ColumbiaGadgetWorks/scorbot/hardware/drv8874-carrier/fab/b/rfq/RFQ_NOTES.txt

DRV8874 carrier, version B - RFQ
=================================

Bare board
  Layers           2, FR-4, 1.6 mm, 1 oz copper both sides
  Finish           HASL (lead-free OK) or ENIG
  Mask / silk      any colour mask, white silk, both sides
  Min track/space  0.15 mm / 0.15 mm
  Min drill        0.3 mm vias (tented), 1.02 mm header holes, 1.152 mm NPTH tooling holes
  Board            15.24 x 17.78 mm (0.6 x 0.7 in)
  Panel            3 x 2 boards, 45.72 x 45.56 mm, V-cut
                   between boards and along both rails (all straight internal lines on the
                   outline layer are V-cuts). 5 mm rails top and bottom with 3 fiducials
                   and 4 tooling holes.

Assembly
  SMT, top side only, 10 placements per board (60 per panel).
  Bottom side has no parts. The 1x7 headers (J1, J2) are not fitted.
  U1 (DRV8874PWPR) has a thermal pad; solder it fully to the pad
  (solder-mask-defined opening, 2 paste windows, vias under the pad).
  Pin 1 of U1 is at the lower-left, next to the silkscreen triangle.

Placement files
  CPL_panel.csv / CPL_single.csv: centre of each part in mm from the lower-left
  corner of the panel (or board), Y up, rotation counter-clockwise in KiCad /
  IPC-7351 zero orientation. (For JLCPCB use fab/b/panel/jlc_cpl.csv, which
  has JLC's rotation correction for U1.)

Quantity
  e.g. 2 panels = 12 boards (bare boards: 5 panels minimum at most fabs)
