ColumbiaGadgetWorks/scorbot/hardware/drv8874-carrier/docs/panel_b.png

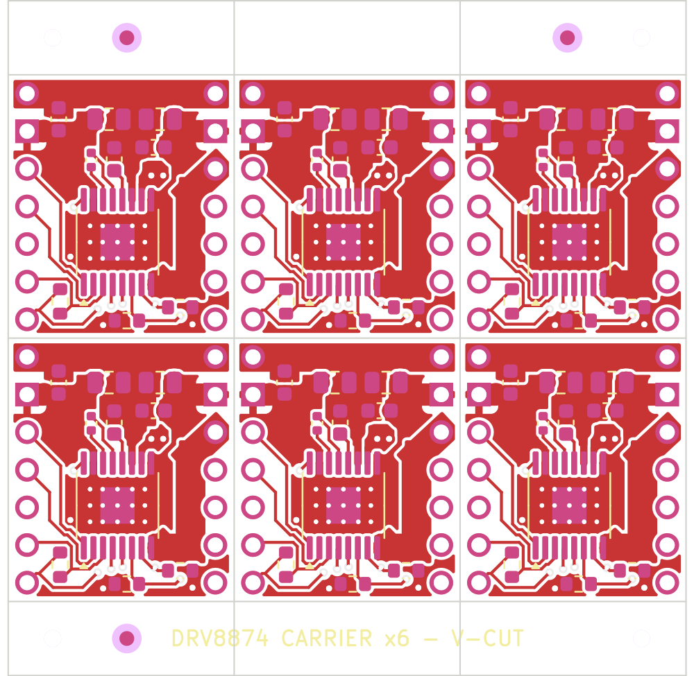
hardware/drv8874-carrier/docs/panel_b.png
