ColumbiaGadgetWorks/scorbot/hardware/drv8874-carrier/docs/version_a.png

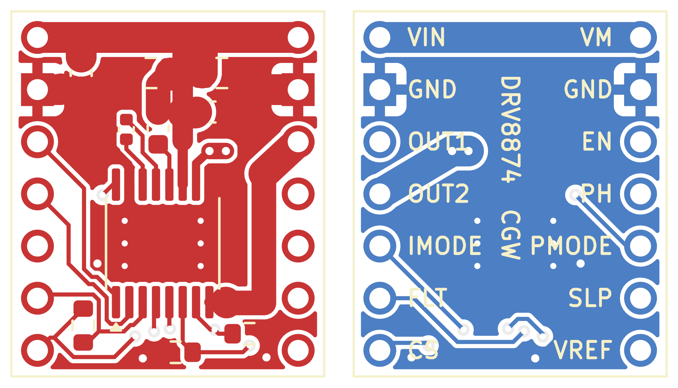
hardware/drv8874-carrier/docs/version_a.png
