ColumbiaGadgetWorks/scorbot/hardware/scorbot-controller/art/stealie.png

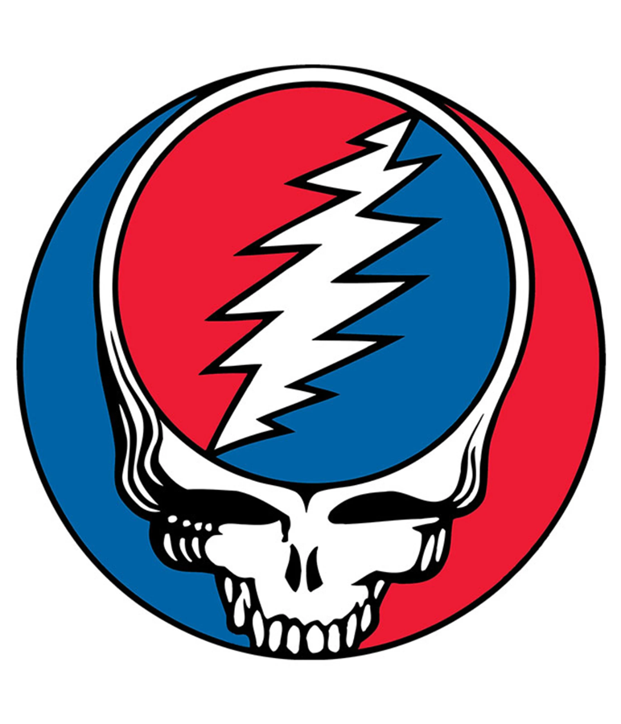
hardware/scorbot-controller/art/stealie.png
