ColumbiaGadgetWorks/scorbot/hardware/scorbot-controller/docs/pcb_placement.png

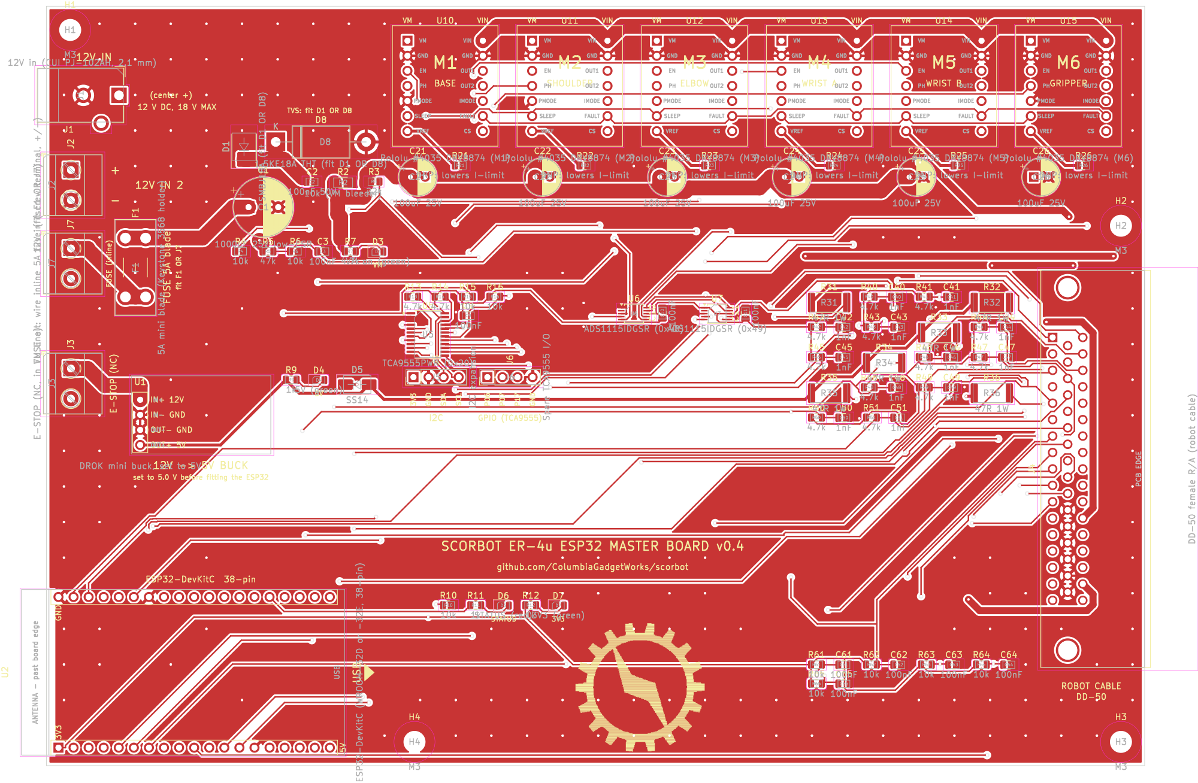
hardware/scorbot-controller/docs/pcb_placement.png
