ColumbiaGadgetWorks/scorbot/hardware/scorbot-controller/docs/pcb_routed_B.png

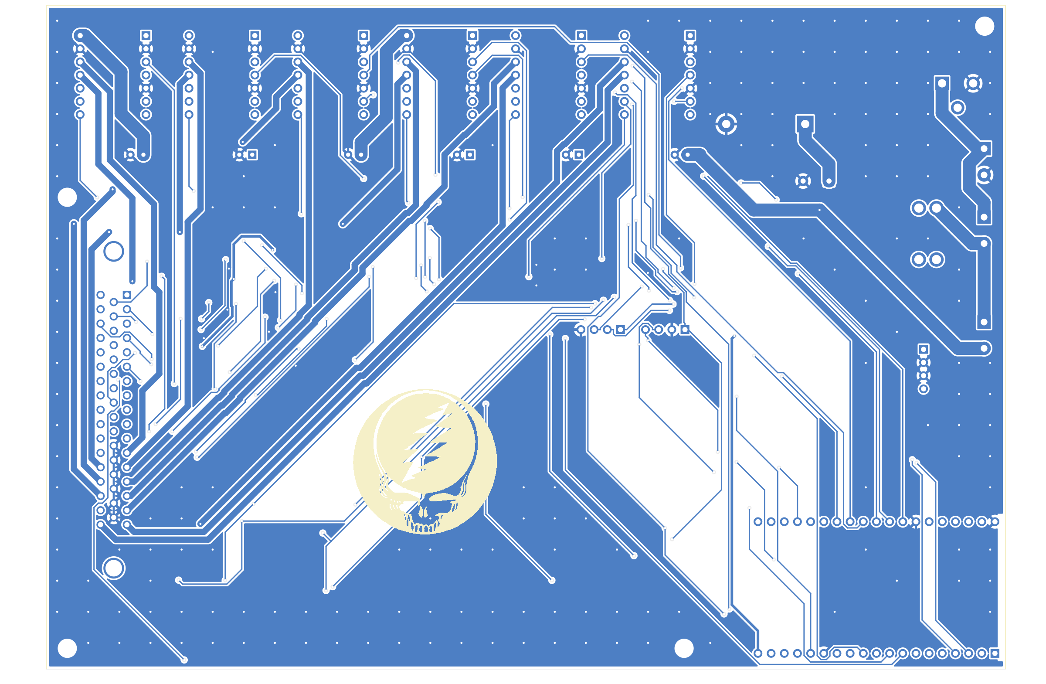
hardware/scorbot-controller/docs/pcb_routed_B.png
