ColumbiaGadgetWorks/scorbot/hardware/drv8874-carrier/fab/JLC_upload_6up_version_b/2_BOM_drv8874_6up.csv

Comment | Designator | Footprint | LCSC Part #
100nF 50V | C3_1,C3_2,C3_3,C3_4,C3_5,C3_6,C4_1,C4_2,C4_3,C4_4,C4_5,C4_6,C6_1,C6_2,C6_3,C6_4,C6_5,C6_6 | C_0603_1608Metric | C14663
DRV8874PWPR | U1_1,U1_2,U1_3,U1_4,U1_5,U1_6 | HTSSOP-16-1EP_4.4x5mm_P0.65mm_EP3.4x5mm_Mask2.46x2.31mm | C1855818
10uF 25V | C1_1,C1_2,C1_3,C1_4,C1_5,C1_6,C2_1,C2_2,C2_3,C2_4,C2_5,C2_6 | C_0805_2012Metric | C15850
10k | R2_1,R2_2,R2_3,R2_4,R2_5,R2_6 | R_0603_1608Metric | C25804
20k | R4_1,R4_2,R4_3,R4_4,R4_5,R4_6 | R_0603_1608Metric | C4184
2.4k 1% | R3_1,R3_2,R3_3,R3_4,R3_5,R3_6 | R_0603_1608Metric | C22940
22nF 50V | C5_1,C5_2,C5_3,C5_4,C5_5,C5_6 | C_0402_1005Metric | C1532
