ColumbiaGadgetWorks/scorbot/hardware/scorbot-controller/docs/schematic.pdf

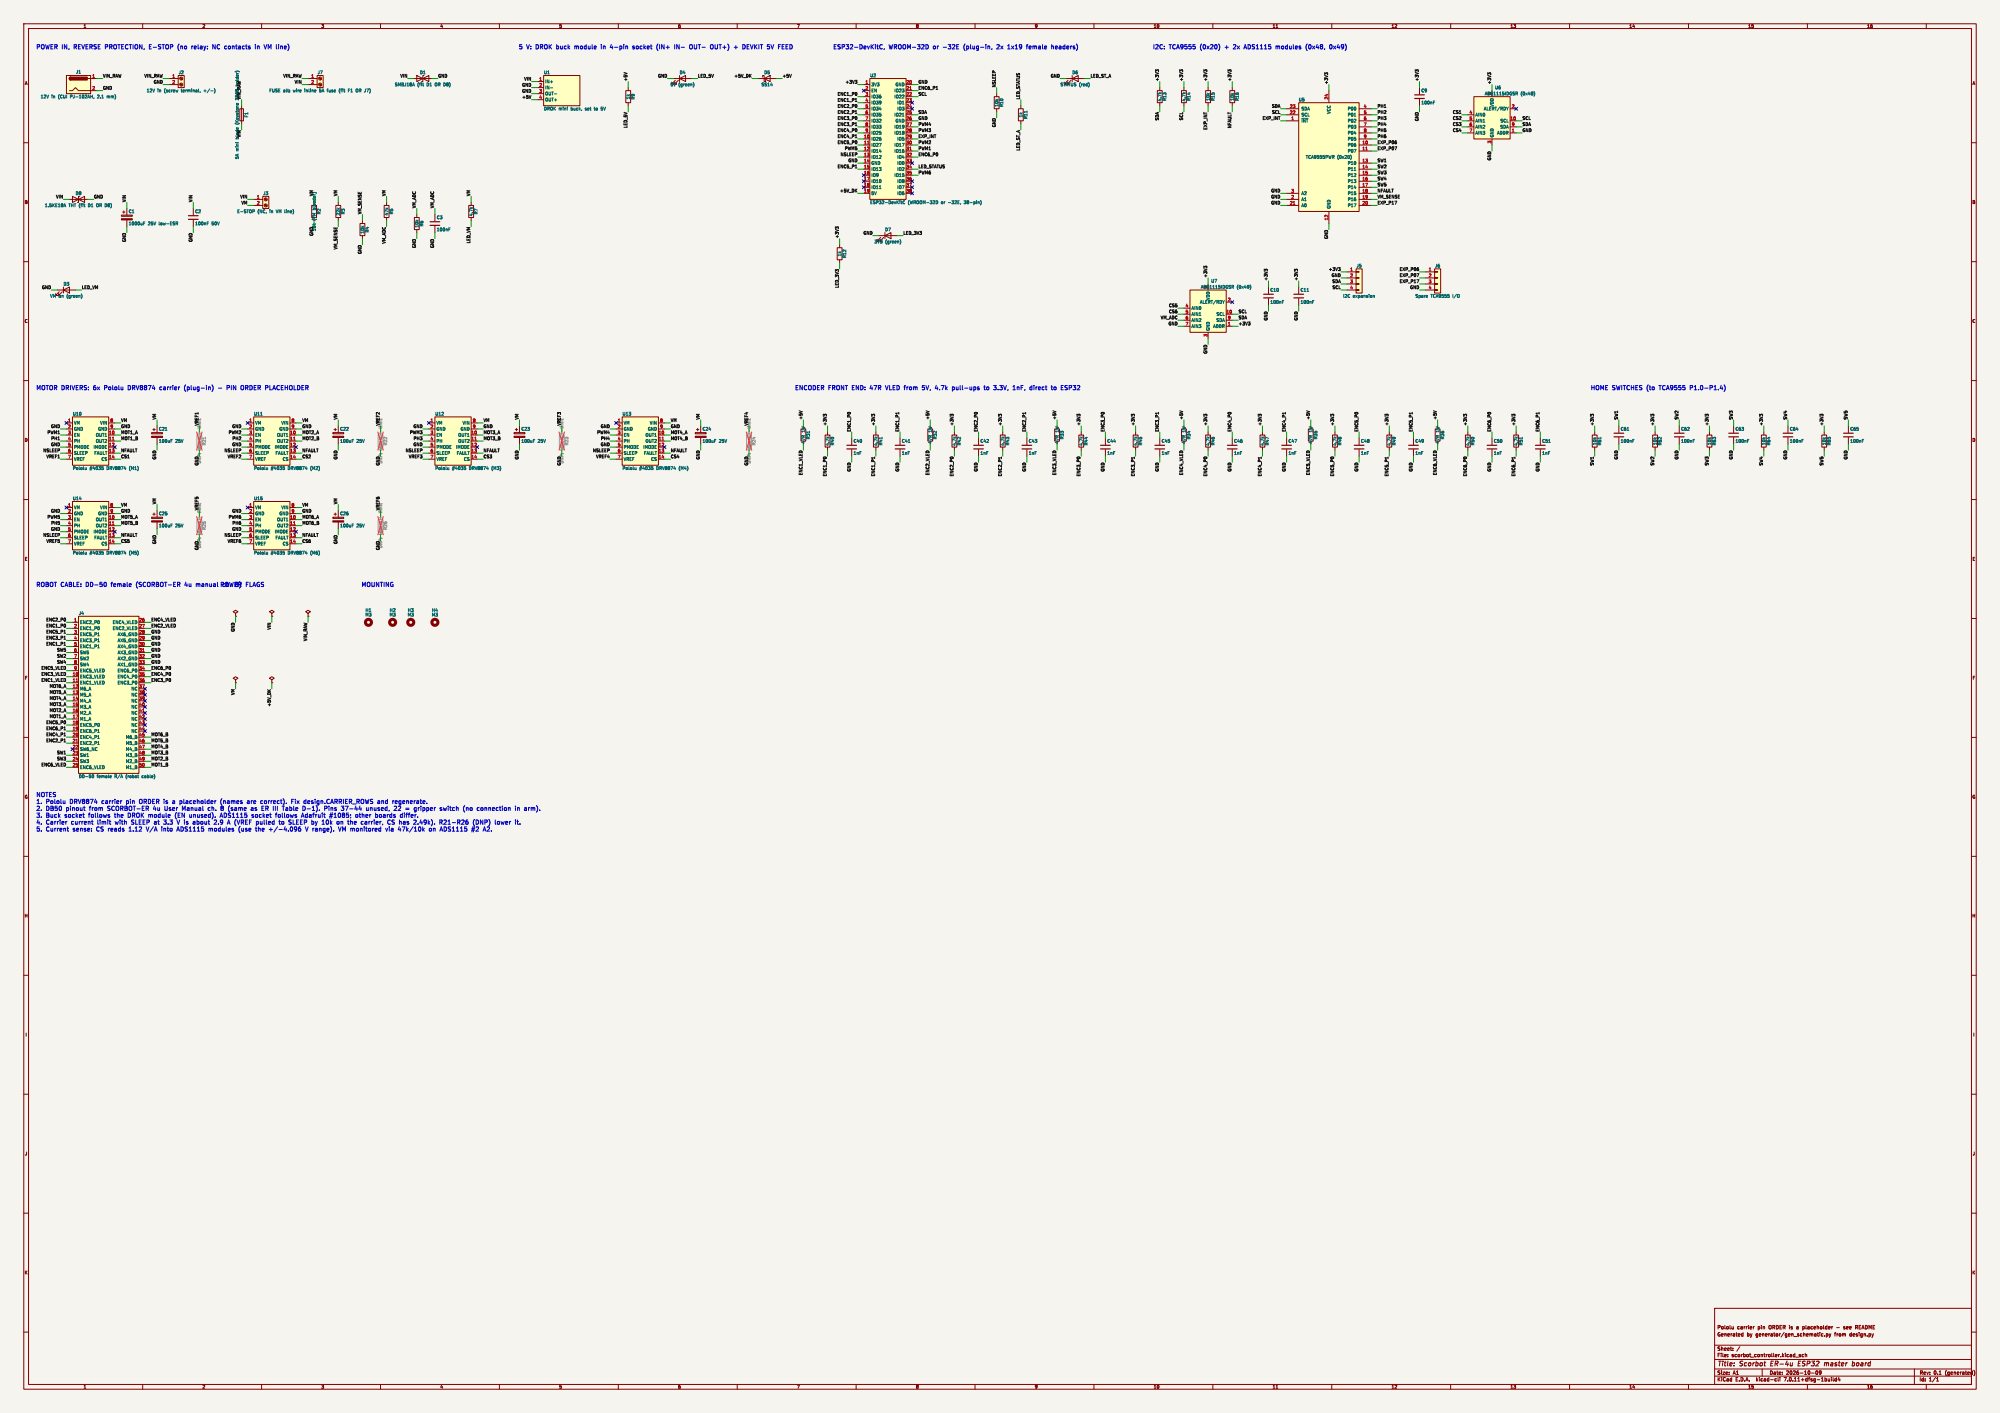
[picture p6: page 1]

J7 FUSE alt: wire inline 5A fuse (fit F1 OR J7) 1

SCL SDA GND GND
