ColumbiaGadgetWorks/scorbot/hardware/drv8874-carrier/drv8874_carrier_panel.kicad_pcb

## KiCad design hardware/drv8874-carrier/drv8874_carrier_panel.kicad_pcb (2026-10-27)

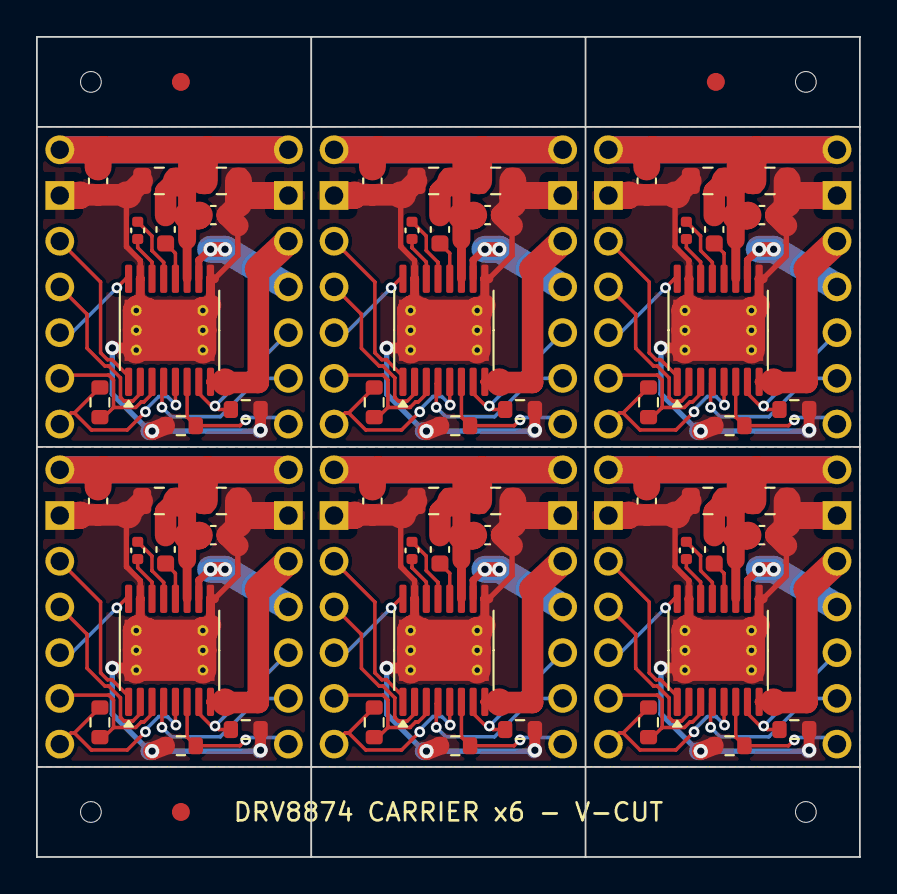
[picture p10: board drv8874_carrier_panel.kicad_pcb from above]

Board: 2 copper layers, 45.7 x 45.6 mm, 79 parts (0 on the bottom side), 15 nets.

Parts:
C1_1, C1_2, C1_3, C1_4, C1_5, C1_6, C2_1, C2_2, C2_3, C2_4, C2_5, C2_6: 10uF 25V; C_0805_2012Metric
C3_1, C3_2, C3_3, C3_4, C3_5, C3_6, C4_1, C4_2, C4_3, C4_4, C4_5, C4_6, C6_1, C6_2, C6_3, C6_4, C6_5, C6_6: 100nF 50V; C_0603_1608Metric
C5_1, C5_2, C5_3, C5_4, C5_5, C5_6: 22nF 50V; C_0402_1005Metric
FID1, FID2, FID3: Fiducial_1mm_Mask2mm
H1, H2, H3, H4: (no value)
J1_1, J1_2, J1_3, J1_4, J1_5, J1_6, J2_1, J2_2, J2_3, J2_4, J2_5, J2_6: 1x7 0.1in pins (hand-soldered); PinHeader_1x07_P2.54mm_Vertical
R2_1, R2_2, R2_3, R2_4, R2_5, R2_6: 10k; R_0603_1608Metric
R3_1, R3_2, R3_3, R3_4, R3_5, R3_6: 2.4k 1%; R_0603_1608Metric
R4_1, R4_2, R4_3, R4_4, R4_5, R4_6: 20k; R_0603_1608Metric
U1_1, U1_2, U1_3, U1_4, U1_5, U1_6: DRV8874PWPR; HTSSOP-16-1EP_4.4x5mm_P0.65mm_EP3.4x5mm_Mask2.46x2.31mm

Connections:
CPH: C5_1.2, C5_2.2, C5_3.2, C5_4.2, C5_5.2, C5_6.2, U1_1.13, U1_2.13, U1_3.13, U1_4.13, U1_5.13, U1_6.13
CPL: C5_1.1, C5_2.1, C5_3.1, C5_4.1, C5_5.1, C5_6.1, U1_1.14, U1_2.14, U1_3.14, U1_4.14, U1_5.14, U1_6.14
CS: J2_1.7, J2_2.7, J2_3.7, J2_4.7, J2_5.7, J2_6.7, R3_1.2, R3_2.2, R3_3.2, R3_4.2, R3_5.2, R3_6.2, U1_1.6, U1_2.6, U1_3.6, U1_4.6, U1_5.6, U1_6.6
EN: J1_1.3, J1_2.3, J1_3.3, J1_4.3, J1_5.3, J1_6.3, U1_1.1, U1_2.1, U1_3.1, U1_4.1, U1_5.1, U1_6.1
FAULT: J2_1.6, J2_2.6, J2_3.6, J2_4.6, J2_5.6, J2_6.6, U1_1.4, U1_2.4, U1_3.4, U1_4.4, U1_5.4, U1_6.4
GND: C1_1.1, C1_2.1, C1_3.1, C1_4.1, C1_5.1, C1_6.1, C2_1.2, C2_2.2, C2_3.2, C2_4.2, C2_5.2, C2_6.2, C3_1.2, C3_2.2, C3_3.2, C3_4.2, C3_5.2, C3_6.2, C4_1.1, C4_2.1, C4_3.1, C4_4.1, C4_5.1, C4_6.1, J1_1.2, J1_2.2, J1_3.2, J1_4.2, J1_5.2, J1_6.2, J2_1.2, J2_2.2, J2_3.2, J2_4.2, J2_5.2, J2_6.2, R3_1.1, R3_2.1, R3_3.1, R3_4.1, R3_5.1, R3_6.1, R4_1.2, R4_2.2, R4_3.2, R4_4.2, R4_5.2, R4_6.2, U1_1.9, U1_1.15, U1_1.17, U1_2.9, U1_2.15, U1_2.17, U1_3.9, U1_3.15, U1_3.17, U1_4.9, U1_4.15, U1_4.17, U1_5.9, U1_5.15, U1_5.17, U1_6.9, U1_6.15, U1_6.17
IMODE: J2_1.5, J2_2.5, J2_3.5, J2_4.5, J2_5.5, J2_6.5, R4_1.1, R4_2.1, R4_3.1, R4_4.1, R4_5.1, R4_6.1, U1_1.7, U1_2.7, U1_3.7, U1_4.7, U1_5.7, U1_6.7
OUT1: J2_1.3, J2_2.3, J2_3.3, J2_4.3, J2_5.3, J2_6.3, U1_1.8, U1_2.8, U1_3.8, U1_4.8, U1_5.8, U1_6.8
OUT2: J2_1.4, J2_2.4, J2_3.4, J2_4.4, J2_5.4, J2_6.4, U1_1.10, U1_2.10, U1_3.10, U1_4.10, U1_5.10, U1_6.10
PH: J1_1.4, J1_2.4, J1_3.4, J1_4.4, J1_5.4, J1_6.4, U1_1.2, U1_2.2, U1_3.2, U1_4.2, U1_5.2, U1_6.2
PMODE: J1_1.5, J1_2.5, J1_3.5, J1_4.5, J1_5.5, J1_6.5, U1_1.16, U1_2.16, U1_3.16, U1_4.16, U1_5.16, U1_6.16
SLEEP: J1_1.6, J1_2.6, J1_3.6, J1_4.6, J1_5.6, J1_6.6, R2_1.1, R2_2.1, R2_3.1, R2_4.1, R2_5.1, R2_6.1, U1_1.3, U1_2.3, U1_3.3, U1_4.3, U1_5.3, U1_6.3
VCP: C6_1.1, C6_2.1, C6_3.1, C6_4.1, C6_5.1, C6_6.1, U1_1.12, U1_2.12, U1_3.12, U1_4.12, U1_5.12, U1_6.12
VM: C1_1.2, C1_2.2, C1_3.2, C1_4.2, C1_5.2, C1_6.2, C2_1.1, C2_2.1, C2_3.1, C2_4.1, C2_5.1, C2_6.1, C3_1.1, C3_2.1, C3_3.1, C3_4.1, C3_5.1, C3_6.1, C4_1.2, C4_2.2, C4_3.2, C4_4.2, C4_5.2, C4_6.2, C6_1.2, C6_2.2, C6_3.2, C6_4.2, C6_5.2, C6_6.2, J1_1.1, J1_2.1, J1_3.1, J1_4.1, J1_5.1, J1_6.1, J2_1.1, J2_2.1, J2_3.1, J2_4.1, J2_5.1, J2_6.1, U1_1.11, U1_2.11, U1_3.11, U1_4.11, U1_5.11, U1_6.11
VREF: J1_1.7, J1_2.7, J1_3.7, J1_4.7, J1_5.7, J1_6.7, R2_1.2, R2_2.2, R2_3.2, R2_4.2, R2_5.2, R2_6.2, U1_1.5, U1_2.5, U1_3.5, U1_4.5, U1_5.5, U1_6.5
