ColumbiaGadgetWorks/scorbot/hardware/drv8874-carrier/drv8874_carrier.kicad_pcb

## KiCad design hardware/drv8874-carrier/drv8874_carrier.kicad_pcb (2026-10-27)

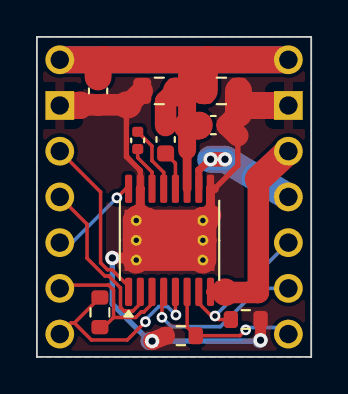
[picture p11: board drv8874_carrier.kicad_pcb from above]

Board: 2 copper layers, 15.2 x 17.8 mm, 12 parts (0 on the bottom side), 15 nets.

Parts:
C1, C2: 10uF 25V; C_0805_2012Metric
C3, C4, C6: 100nF 50V; C_0603_1608Metric
C5: 22nF 50V; C_0402_1005Metric
J1, J2: 1x7 0.1in pins (hand-soldered); PinHeader_1x07_P2.54mm_Vertical
R2: 10k; R_0603_1608Metric
R3: 2.4k 1%; R_0603_1608Metric
R4: 20k; R_0603_1608Metric
U1: DRV8874PWPR; HTSSOP-16-1EP_4.4x5mm_P0.65mm_EP3.4x5mm_Mask2.46x2.31mm

Connections:
CPH: C5.2, U1.13
CPL: C5.1, U1.14
CS: J2.7, R3.2, U1.6
EN: J1.3, U1.1
FAULT: J2.6, U1.4
GND: C1.1, C2.2, C3.2, C4.1, J1.2, J2.2, R3.1, R4.2, U1.9, U1.15, U1.17
IMODE: J2.5, R4.1, U1.7
OUT1: J2.3, U1.8
OUT2: J2.4, U1.10
PH: J1.4, U1.2
PMODE: J1.5, U1.16
SLEEP: J1.6, R2.1, U1.3
VCP: C6.1, U1.12
VM: C1.2, C2.1, C3.1, C4.2, C6.2, J1.1, J2.1, U1.11
VREF: J1.7, R2.2, U1.5
