ColumbiaGadgetWorks/scorbot/hardware/scorbot-controller/generator/design.py

"""Single source of truth for the Scorbot ER-4u master board.

Every part, its symbol, footprint, pin-to-net mapping and rough placement
lives here. gen_library.py, gen_schematic.py and gen_pcb.py all read this
file, so a change here (for example the Pololu carrier pin order) is made
once and the schematic and PCB are regenerated from it.
"""

# ---------------------------------------------------------------------------
# Footprint shorthands
# ---------------------------------------------------------------------------
R0805 = "Resistor_SMD:R_0805_2012Metric"
R1206 = "Resistor_SMD:R_1206_3216Metric"
C0805 = "Capacitor_SMD:C_0805_2012Metric"
C1206 = "Capacitor_SMD:C_1206_3216Metric"
R2512 = "Resistor_SMD:R_2512_6332Metric"
LED0805 = "LED_SMD:LED_0805_2012Metric"

# ---------------------------------------------------------------------------
# ER-4u DB50 pinout (SCORBOT-ER 4u User Manual, Chapter 8 "Robot Wiring";
# identical pin numbers to the ER III manual Table D-1).
# Axis order: 1 base, 2 shoulder, 3 elbow, 4 wrist motor A, 5 wrist motor B,
# 6 gripper. The manual's +/- motor labels are irrelevant: firmware sets
# each axis's direction.
# ---------------------------------------------------------------------------
AXES = {
    1: dict(name="BASE",     mot_a=17, mot_b=50, p0=2,  p1=5,  vled=11, gnd=33, sw=23),
    2: dict(name="SHOULDER", mot_a=16, mot_b=49, p0=1,  p1=21, vled=27, gnd=32, sw=7),
    3: dict(name="ELBOW",    mot_a=15, mot_b=48, p0=36, p1=4,  vled=10, gnd=31, sw=24),
    4: dict(name="WRIST_A",  mot_a=14, mot_b=47, p0=35, p1=20, vled=26, gnd=30, sw=8),
    5: dict(name="WRIST_B",  mot_a=13, mot_b=46, p0=18, p1=3,  vled=9,  gnd=29, sw=6),
    6: dict(name="GRIPPER",  mot_a=12, mot_b=45, p0=34, p1=19, vled=25, gnd=28, sw=None),
}
DB50_GRIPPER_SW_NC = 22          # wired in the cable, nothing in the arm
DB50_UNUSED = list(range(37, 45))  # 37-44 unused on ER III and ER-4u


def db50_pin_names():
    names = {}
    for i, a in AXES.items():
        names[a["mot_a"]] = f"M{i}_A"
        names[a["mot_b"]] = f"M{i}_B"
        names[a["p0"]] = f"ENC{i}_P0"
        names[a["p1"]] = f"ENC{i}_P1"
        names[a["vled"]] = f"ENC{i}_VLED"
        names[a["gnd"]] = f"AX{i}_GND"
        if a["sw"]:
            names[a["sw"]] = f"SW{i}"
    names[DB50_GRIPPER_SW_NC] = "SW6_NC"
    for p in DB50_UNUSED:
        names[p] = "NC"
    assert sorted(names) == list(range(1, 51)), "DB50 map must cover pins 1-50"
    return names


# ---------------------------------------------------------------------------
# ESP32-DevKitC V4 layout (38-pin, WROOM-32D or -32E; pin labels checked
# against a photo of the user's WROOM-32D board). Pins 1-19 = header J2 (3V3 end
# first), pins 20-38 = header J3 (GND end first). The 3V3/GND end is the
# antenna end; the 5V/CLK end is the USB end.
# ---------------------------------------------------------------------------
DEVKIT_PINS = [
    # J2
    "3V3", "EN", "IO36", "IO39", "IO34", "IO35", "IO32", "IO33", "IO25",
    "IO26", "IO27", "IO14", "IO12", "GND", "IO13", "IO9", "IO10", "IO11", "5V",
    # J3
    "GND", "IO23", "IO22", "IO1", "IO3", "IO21", "GND", "IO19", "IO18", "IO5",
    "IO17", "IO16", "IO4", "IO0", "IO2", "IO15", "IO8", "IO7", "IO6",
]
DEVKIT_ROW_SPACING = 25.4  # mm between J2 and J3 (photo of the board in hand fits 25.4; confirm with calipers)

# ---------------------------------------------------------------------------
# Pololu DRV8874 carrier (#4035), 0.6" x 0.7", two rows of 7 pins 0.5" apart.
# Pin order from Pololu's "top view with labeled pinout" (product page,
# checked 2026-10-11), as seen from above with the carrier plugged in
# components-up. Rows are listed top to bottom.
# ---------------------------------------------------------------------------
CARRIER_ROWS = [
    ["VM", "GND", "EN", "PH", "PMODE", "SLEEP", "VREF"],      # left: logic side
    ["VIN", "GND", "OUT1", "OUT2", "IMODE", "FAULT", "CS"],   # right: motor side
]
CARRIER_ROW_SPACING = 12.7  # mm (0.5")


# ---------------------------------------------------------------------------
# Plug-in modules on 0.1" headers. PIN ORDER IS A PLACEHOLDER until checked
# against the module you buy (pololu.com / seller listings were unreachable).
# ---------------------------------------------------------------------------
# DROK mini buck module (set to 5 V with its "5V" solder jumper). Its header
# row is EN, IN+, IN-, OUT-, OUT+; the board socket takes the last four
# (EN is left unconnected; floating = enabled on these modules).
BUCK_PINS = ["IN+", "IN-", "OUT-", "OUT+"]


def carrier_pins():
    """Pin number -> name for the carrier, numbered row by row."""
    out, n = {}, 1
    for row in CARRIER_ROWS:
        for name in row:
            out[n] = name
            n += 1
    return out


# ---------------------------------------------------------------------------
# Parts
# ---------------------------------------------------------------------------
PARTS = []


def part(ref, lib, value, fp, nets, group, pcb=None, dnp=False, **extra):
    """nets: {pin_number(str): net_name or None for no-connect}."""
    p = dict(ref=ref, lib=lib, value=value, fp=fp,
             nets={str(k): v for k, v in nets.items()},
             group=group, pcb=pcb, dnp=dnp)
    p.update(extra)
    PARTS.append(p)
    return p


def R(ref, value, a, b, group, fp=R0805, pcb=None, dnp=False):
    return part(ref, "Device:R", value, fp, {1: a, 2: b}, group, pcb, dnp)


def C(ref, value, a, b, group, fp=C0805, pcb=None):
    return part(ref, "Device:C", value, fp, {1: a, 2: b}, group, pcb)


def CP(ref, value, plus, minus, group, fp, pcb=None):
    return part(ref, "Device:C_Polarized", value, fp, {1: plus, 2: minus}, group, pcb)


def LED(ref, value, anode, cathode, group, pcb=None):
    return part(ref, "Device:LED", value, LED0805, {1: cathode, 2: anode}, group, pcb)


# ---- Power input ---------------------------------------------------------
part("J1", "Connector:Barrel_Jack", "12V in (CUI PJ-102AH, 2.1 mm)",
     "Connector_BarrelJack:BarrelJack_CUI_PJ-102AH_Horizontal",
     {1: "VIN_RAW", 2: "GND"}, "power", pcb=(9, 14, 0))
SCREW2 = "TerminalBlock_Phoenix:TerminalBlock_Phoenix_MKDS-1,5-2-5.08_1x02_P5.08mm_Horizontal"
# Power input: barrel jack J1 OR screw terminal J2 (both fitted, use one).
part("J2", "Connector:Screw_Terminal_01x02", "12V in (screw terminal, +/-)", SCREW2,
     {1: "VIN_RAW", 2: "GND"}, "power", pcb=(5, 32, 90))
# Fuse, two options in parallel -- fit ONE:
#   F1  on-board mini blade (ATM) fuse holder, or
#   J7  screw terminal with an inline fuse holder wired across it.
part("F1", "Device:Fuse", "5A mini blade (Keystone 3568 holder)",
     "Fuse:Fuseholder_Blade_Mini_Keystone_3568",
     {1: "VIN_RAW", 2: "VIN"}, "power", pcb=(28, 22, 0))
part("J7", "Connector:Screw_Terminal_01x02", "FUSE alt: wire inline 5A fuse (fit F1 OR J7)", SCREW2,
     {1: "VIN_RAW", 2: "VIN"}, "power", pcb=(28, 22, 90))
# No reverse-polarity FET: a reversed supply forward-biases the unidirectional
# TVS and blows the external fuse on J7. The driver carriers and buck module also protect themselves.
# Fit ONE of these by hand (both are left out of the JLC assembly):
#   D1  SMBJ18A, SMB package, or
#   D8  through-hole 1.5KE18A / P6KE18A (or any 1N540x-class rectifier for
#       reverse-polarity only, without the over-voltage clamp).
part("D1", "Device:D_TVS", "SMBJ18A (fit D1 OR D8)", "Diode_SMD:D_SMB",
     {1: "VIN", 2: "GND"}, "power", pcb=(40, 44, 90), hand=True)
part("D8", "Device:D_TVS", "1.5KE18A THT (fit D1 OR D8)", "Diode_THT:D_DO-201AD_P15.24mm_Horizontal",
     {1: "VIN", 2: "GND"}, "power", pcb=(40, 44, 0), hand=True)
CP("C1", "1000uF 25V low-ESR", "VIN", "GND", "power",
   "Capacitor_THT:CP_Radial_D10.0mm_P5.00mm", pcb=(14, 58, 0))
C("C2", "100nF 50V", "VIN", "GND", "power", pcb=(26, 58, 0))

# ---- E-stop (no relay): NC contacts in series with the motor rail --------
part("J3", "Connector:Screw_Terminal_01x02", "E-STOP (NC, in VM line)", SCREW2,
     {1: "VIN", 2: "VM"}, "power", pcb=(6, 74, 90))
R("R2", "10k (VM bleeder)", "VM", "GND", "power", fp=R1206, pcb=(22, 70, 0))
R("R3", "22k", "VM", "VM_SENSE", "power", pcb=(22, 74, 0))
R("R4", "10k", "VM_SENSE", "GND", "power", pcb=(22, 77, 0))
R("R5", "47k", "VM", "VM_ADC", "power", pcb=(30, 74, 0))
R("R6", "10k", "VM_ADC", "GND", "power", pcb=(30, 77, 0))
C("C3", "100nF", "VM_ADC", "GND", "power", pcb=(30, 80, 0))
R("R7", "4.7k", "VM", "LED_VM", "power", pcb=(38, 70, 0))
LED("D3", "VM on (green)", "LED_VM", "GND", "power", pcb=(38, 74, 0))

# ---- 5 V: plug-in DROK buck module (4-pin socket) ------------------------------
part("U1", "Scorbot:Buck_Module_4pin", "DROK mini buck, set to 5V", "Scorbot:Buck_Module_4pin_Socket",
     {i + 1: {"IN+": "VIN", "IN-": "GND", "OUT-": "GND", "OUT+": "+5V"}[n] for i, n in enumerate(BUCK_PINS)},
     "buck", pcb=(36, 58, 0))
R("R9", "1k", "+5V", "LED_5V", "buck", pcb=(38, 80, 0))
LED("D4", "5V (green)", "LED_5V", "GND", "buck", pcb=(38, 83, 0))
part("D5", "Device:D_Schottky", "SS14", "Diode_SMD:D_SMA",
     {1: "+5V_DK", 2: "+5V"}, "buck", pcb=(46, 76, 0))

# ---- ESP32 DevKit ---------------------------------------------------------
esp_net = {
    "3V3": "+3V3", "5V": "+5V_DK", "GND": "GND",
    "IO36": "ENC1_P0", "IO39": "ENC1_P1", "IO34": "ENC2_P0", "IO35": "ENC2_P1",
    "IO32": "ENC3_P0", "IO33": "ENC3_P1", "IO25": "ENC4_P0", "IO26": "ENC4_P1",
    "IO27": "ENC5_P0", "IO13": "ENC5_P1", "IO4": "ENC6_P0", "IO23": "ENC6_P1",
    "IO16": "PWM1", "IO17": "PWM2", "IO18": "PWM3", "IO19": "PWM4",
    "IO14": "PWM5", "IO15": "PWM6",
    "IO12": "NSLEEP", "IO21": "SDA", "IO22": "SCL", "IO5": "EXP_INT",
    "IO2": "LED_STATUS",
}
part("U2", "Scorbot:ESP32_DevKitC_V4", "ESP32-DevKitC (WROOM-32D or -32E, 38-pin)",
     "Scorbot:ESP32_DevKitC_V4_Socket",
     {i + 1: esp_net.get(n) for i, n in enumerate(DEVKIT_PINS)},
     "mcu", pcb=(14, 98, 270))
R("R10", "10k", "NSLEEP", "GND", "mcu", pcb=(62, 100, 0))
R("R11", "1k", "LED_STATUS", "LED_ST_A", "mcu", pcb=(62, 104, 0))
LED("D6", "STATUS (red)", "LED_ST_A", "GND", "mcu", pcb=(62, 108, 0))
R("R12", "1k", "+3V3", "LED_3V3", "mcu", pcb=(62, 112, 0))
LED("D7", "3V3 (green)", "LED_3V3", "GND", "mcu", pcb=(62, 116, 0))

# ---- I2C: TCA9555 + 2x ADS1115 (placed by JLC) ---------------------------------------
R("R13", "4.7k", "+3V3", "SDA", "i2c", pcb=(72, 70, 0))
R("R14", "4.7k", "+3V3", "SCL", "i2c", pcb=(72, 73, 0))
R("R15", "10k", "+3V3", "EXP_INT", "i2c", pcb=(72, 76, 0))
R("R16", "10k", "+3V3", "NFAULT", "i2c", pcb=(72, 79, 0))
tca = {1: "EXP_INT", 2: "GND", 3: "GND", 21: "GND", 22: "SCL", 23: "SDA",
       24: "+3V3", 12: "GND",
       4: "PH1", 5: "PH2", 6: "PH3", 7: "PH4", 8: "PH5", 9: "PH6",
       10: "EXP_P06", 11: "EXP_P07",
       13: "SW1", 14: "SW2", 15: "SW3", 16: "SW4", 17: "SW5",
       18: "NFAULT", 19: "VM_SENSE", 20: "EXP_P17"}
part("U5", "Interface_Expansion:TCA9555PWR", "TCA9555PWR (0x20)",
     "Package_SO:TSSOP-24_4.4x7.8mm_P0.65mm", tca, "i2c", pcb=(84, 56, 0))
C("C9", "100nF", "+3V3", "GND", "i2c", pcb=(84, 48, 0))
# ADS1115IDGSR (VSSOP-10): 1 ADDR, 2 ALERT/RDY, 3 GND, 4-7 AIN0-3, 8 VDD, 9 SDA, 10 SCL.
# ADDR straight to GND -> 0x48, to VDD -> 0x49. ALERT/RDY is unused.
ads_a = {1: "GND", 2: None, 3: "GND", 4: "CS1", 5: "CS2", 6: "CS3", 7: "CS4", 8: "+3V3", 9: "SDA", 10: "SCL"}
ads_b = dict(ads_a)
ads_b.update({1: "+3V3", 4: "CS5", 5: "CS6", 6: "VM_ADC", 7: "GND"})
part("U6", "Analog_ADC:ADS1115IDGS", "ADS1115IDGSR (0x48)", "Package_SO:TSSOP-10_3x3mm_P0.5mm",
     ads_a, "i2c", pcb=(104, 56, 0))
part("U7", "Analog_ADC:ADS1115IDGS", "ADS1115IDGSR (0x49)", "Package_SO:TSSOP-10_3x3mm_P0.5mm",
     ads_b, "i2c", pcb=(104, 76, 0))
C("C10", "100nF", "+3V3", "GND", "i2c", pcb=(104, 52, 0))
C("C11", "100nF", "+3V3", "GND", "i2c", pcb=(104, 72, 0))
part("J5", "Connector_Generic:Conn_01x04", "I2C expansion",
     "Connector_PinHeader_2.54mm:PinHeader_1x04_P2.54mm_Vertical",
     {1: "+3V3", 2: "GND", 3: "SDA", 4: "SCL"}, "i2c", pcb=(84, 112, 90))
part("J6", "Connector_Generic:Conn_01x04", "Spare TCA9555 I/O",
     "Connector_PinHeader_2.54mm:PinHeader_1x04_P2.54mm_Vertical",
     {1: "EXP_P06", 2: "EXP_P07", 3: "EXP_P17", 4: "GND"}, "i2c", pcb=(100, 112, 90))

# ---- Motor drivers (Pololu DRV8874 carriers) -------------------------------
cpins = carrier_pins()
for i in range(1, 7):
    nets = {}
    for num, name in cpins.items():
        nets[num] = {
            "VIN": "VM", "VM": None, "GND": "GND", "OUT1": f"MOT{i}_A",
            "OUT2": f"MOT{i}_B", "PMODE": "GND", "IMODE": None,
            "EN": f"PWM{i}", "PH": f"PH{i}", "SLEEP": "NSLEEP",
            "FAULT": "NFAULT", "CS": f"CS{i}", "VREF": f"VREF{i}",
        }[name]
    x = 62 + (i - 1) * 21
    part(f"U{9 + i}", "Scorbot:Pololu_DRV8874_Carrier",
         f"Pololu #4035 DRV8874 (M{i})", "Scorbot:Pololu_DRV8874_Carrier_Socket",
         nets, "drivers", pcb=(x, 6, 0))
    CP(f"C{20 + i}", "100uF 25V", "VM", "GND", "drivers",
       "Capacitor_THT:CP_Radial_D6.3mm_P2.50mm", pcb=(x + 4, 34, 0))
    R(f"R{20 + i}", "DNP: lowers I-limit", f"VREF{i}", "GND", "drivers",
      pcb=(x + 12, 34, 0), dnp=True)

# ---- Encoder + switch front end ---------------------------------------------
# No buffers: the encoders are open phototransistors, so 4.7k pull-ups to 3.3 V
# make them ESP32-safe. 1 nF + the ESP32 PCNT glitch filter handle noise.
for i in range(1, 7):
    y0 = 44 + (i - 1) * 11
    # ~80 mA through 47 R from 5 V (IR LED drops ~1.2 V) = ~0.3 W: 2512, 1 W.
    R(f"R{30 + i}", "47R 1W", "+5V", f"ENC{i}_VLED", "encoders", fp=R2512, pcb=(132, y0, 0))
    for k, sig in ((0, "P0"), (1, "P1")):
        n = (i - 1) * 2 + k
        R(f"R{40 + n}", "4.7k", "+3V3", f"ENC{i}_{sig}", "encoders", pcb=(140, y0 + k * 3, 0))
        C(f"C{40 + n}", "1nF", f"ENC{i}_{sig}", "GND", "encoders", pcb=(146, y0 + k * 3, 0))
for i in range(1, 6):
    R(f"R{60 + i}", "10k", "+3V3", f"SW{i}", "switches", pcb=(100, 66 + i * 4, 0))
    C(f"C{60 + i}", "100nF", f"SW{i}", "GND", "switches", pcb=(108, 66 + i * 4, 0))

# ---- DB50 (robot cable) ------------------------------------------------------
db = {}
for i, a in AXES.items():
    db[a["mot_a"]] = f"MOT{i}_A"
    db[a["mot_b"]] = f"MOT{i}_B"
    db[a["p0"]] = f"ENC{i}_P0"
    db[a["p1"]] = f"ENC{i}_P1"
    db[a["vled"]] = f"ENC{i}_VLED"
    db[a["gnd"]] = "GND"
    if a["sw"]:
        db[a["sw"]] = f"SW{i}"
db[DB50_GRIPPER_SW_NC] = None
for p in DB50_UNUSED:
    db[p] = None
part("J4", "Scorbot:DD50_Female", "DD-50 female R/A (robot cable)",
     "Scorbot:DD50_Female_Horizontal_P2.77x2.54mm_EdgePinOffset10.40mm", db, "db50", pcb=(170, 54, 90))

# ---- Power flags + mounting holes -------------------------------------------
for k, net in enumerate(["GND", "VIN", "VIN_RAW", "VM", "+5V_DK"]):
    part(f"#FLG0{k + 1}", "power:PWR_FLAG", "PWR_FLAG", "", {1: net}, "flags")
for k, xy in enumerate([(4, 4), (181, 4), (4, 124), (181, 124)]):
    part(f"H{k + 1}", "Mechanical:MountingHole", "M3", "MountingHole:MountingHole_3.2mm_M3",
         {}, "holes", pcb=(xy[0], xy[1], 0))

BOARD_W, BOARD_H = 185.0, 128.0

if __name__ == "__main__":
    from collections import defaultdict
    nets = defaultdict(list)
    for p in PARTS:
        for pin, n in p["nets"].items():
            if n:
                nets[n].append(f"{p['ref']}.{pin}")
    for n in sorted(nets):
        print(f"{n:<12} {len(nets[n]):>3}  {' '.join(nets[n][:8])}{' ...' if len(nets[n]) > 8 else ''}")
    single = [n for n, v in nets.items() if len(v) < 2]
    print("parts:", len(PARTS), "nets:", len(nets), "single-pin nets:", single)
