ColumbiaGadgetWorks/scorbot/(commit log)

2026-10-09 Add generated KiCad project for Scorbot ER-4u ESP32 master board
    Schematic, placed (unrouted) PCB, custom DevKit/DRV8874-carrier/DD-50
    footprints and a Python generator with design.py as the single source of
    truth. generate.sh rebuilds everything and checks the KiCad netlist against
    the design and runs DRC. DB50 pinout from the ER-4u manual ch. 8.
    [bom.csv, scorbot_controller.kicad_pcb, scorbot_controller.kicad_sch]
2026-10-10 Swap buck, ADC and encoder buffers for plug-in modules
    Replace the AP63205 buck with a Pololu D24V22F5 module, the ADS7828 with
    two ADS1115 breakout modules, drop the 74LVC14 encoder buffers (4.7k
    pull-ups to 3.3V straight to the ESP32) and the reverse-polarity FET.
    TCA9555 stays as the only SMD IC. Module pin orders are placeholders.
    [bom.csv, scorbot_controller.kicad_pcb, scorbot_controller.kicad_sch]
2026-10-10 Update schematic notes for the module-based design
    [scorbot_controller.kicad_pcb, scorbot_controller.kicad_sch]
2026-10-10 Board rev: screw terminals for fuse and E-stop, 4-pin DROK buck socket
    Fuse holder replaced by a screw terminal (wire an inline fuse across it),
    E-stop plug replaced by a screw terminal, buck module socket now IN+, IN-,
    OUT-, OUT+ to match the DROK mini buck. Barrel jack footprint matched to
    CUI PJ-102AH. ADS1115 socket follows Adafruit #1085. DevKit relabelled for
    WROOM-32D or -32E (same pins).
    [bom.csv, scorbot_controller.kicad_pcb, scorbot_controller.kicad_sch]
2026-10-10 Add ESP-IDF firmware, web UI with test/calibration/3D view, and simulator tests
    - Robot core: 1 kHz PID with trapezoid moves, differential wrist, homing,
    travel calibration, motor/switch/encoder self-tests, safety latches
    - ESP32 HAL: PCNT encoders, LEDC PWM, TCA9555 + 2x ADS1115 over I2C
    - WiFi STA with AP/captive-portal fallback, mDNS, HTTP + WebSocket API
    - Single-file web UI: 3D arm view, jog, test, calibrate and settings tabs,
    demo mode with a mock arm
    - Host tests: core unit tests on a physics sim, sim bridge, Playwright UI test
2026-10-11 Board: screw-terminal power input beside the barrel jack, optional on-board blade fuse holder
    - J2 is now a plain 5.08 mm screw terminal (alternative to barrel jack J1)
    - F1 Keystone 3568 mini blade holder in parallel with the J7 fuse terminal; fit one
    - Net classes for Power/Motor/Supply; gen_route.py autoroutes with Freerouting
    [bom.csv, scorbot_controller.kicad_pcb, scorbot_controller.kicad_sch]
2026-10-11 Keep net classes in the project file after board saves; ignore router logs
2026-10-11 gen_route: import Freerouting sessions directly, keep off the board edge, add top GND pour
2026-10-11 Autoroute the master board with Freerouting
    - gen_route.py: DSN export with per-class widths (Power 1.5 mm, Motor 0.8 mm,
    Supply 0.5 mm, GND 0.4 mm + pours), headless Freerouting, direct session
    import, GND pours on both layers with stitching vias, retry until complete
    - DRC: 0 unconnected, 0 clearance errors
    - Routed F/B previews in docs/
    [scorbot_controller.kicad_pcb]
2026-10-11 Add JLCPCB fab outputs (Gerbers, drill, BOM, CPL) and a pre-order checklist
    [jlc_bom.csv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]
2026-10-11 v0.3: verified carrier pinout, on-board ADS1115s, wider power traces, SMD or THT TVS
    - DRV8874 carrier socket from Pololu's labeled top view (2x7, 0.5in rows),
    VM/VIN orientation marks on the silkscreen
    - ADS1115IDGSR x2 placed by JLC (0x48/0x49 by ADDR strap) replace the plug-in
    modules; 100nF decoupling each
    - 1 oz copper: VIN/VM 2.5 mm with 1.6/0.8 mm vias, motor 1.2 mm with 1.2/0.6 mm vias
    - D1 SMBJ18A (SMB) or D8 1.5KE18A (DO-201AD THT), hand-fitted, out of the JLC BOM
    - JLC BOM grouped by LCSC part; README: how to check part numbers and orientation
    [bom.csv, jlc_bom.csv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]
2026-10-11 v0.4: DD-50 footprint per Amphenol DD50S564TLF, logos on silkscreen, LCSC fixes
    - DD-50: tail rows 2.54 mm apart, row 3 10.40 mm from the flange (Amphenol
    D-Sub brochure, termination type 5); bracket holes still to confirm
    - Columbia Gadget Works logo on F.SilkS, Stealie on B.SilkS (silk_art.py)
    - R31-R36 47R now 2512 1 W (~0.3 W each); D6 status LED red (C84256)
    - Clear LCSC numbers that turned out wrong (TCA9555, 47R); previews draw silk on top
    [bom.csv, jlc_bom.csv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]
2026-10-11 JLC BOM: TCA9555PWR C465732 confirmed, 47R 2512 1W C341654
    [jlc_bom.csv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]
2026-10-11 README: DD-50 bracket holes not blocking; board ready to order
2026-10-11 Fab: rotate TSSOPs -90 degrees in the JLC CPL
    JLC's placement preview showed U5 (TCA9555) and U6/U7 (ADS1115) turned
    90 degrees, with leads crossing the pads. Their TSSOP models put pin 1 at
    bottom left with the pins along the top and bottom. D5 and the LEDs were
    already correct.
    [jlc_cpl.csv]
2026-10-11 Firmware: switch to Pololu #4036 DRV8876 carriers
    - CS scaling 2.49 V/A (1000 uA/A x 2.49k) instead of 1.12 V/A.
    - The driver now chops at about 1.33 A (VREF 3.3 V), so the software
    over-current trip defaults to 1.2 A, and saved values at or above the
    driver limit fall back to the default.
    - The trip now needs 500 ms of over-current instead of 50 ms. A stall sits
    at the chop limit, so this lets the stall and following-error checks
    report it first.
    - Web UI current meters scaled to 1.5 A; sim clamps current at the driver
    limit; new host test for the over-current trip.
    The board is unchanged: the #4036 uses the same carrier sockets.
    [board.h, config.h, robot.cpp, settings.cpp, sim_hal.h, test_core.cpp]
2026-10-27 Firmware: DRV8874 by default, DRV8876 as a menuconfig option
    The driver choice now lives in core/config.h: DRV8874 (Pololu #4035 or
    the new carrier clone) by default, with 1.12 V/A current sense, about
    2.9 A chop limit and a 2.5 A software trip. Turning on
    CONFIG_SCORBOT_DRV8876 (or -DSCORBOT_DRV8876) selects the #4036 values:
    2.49 V/A, 1.33 A and 1.2 A. The over-current test and the web UI's
    current meters follow the selected driver.
2026-10-27 Add a DRV8874 carrier board (Pololu #4035 clone) for JLC assembly
    Same 0.6 x 0.7 in size and 2x7 pinout as Pololu's DRV887x carrier, so it
    plugs into the master board's driver sockets. It follows Pololu's
    schematic without the reverse-voltage MOSFET (the master board protects
    VM), with VCP at TI's 100 nF.
    gen_board.py places the parts and hand-draws VM, OUT1 and OUT2 as locked
    1.0-1.2 mm copper. Freerouting routes the rest, and both layers get GND
    pours with stitching vias. Version B adds Pololu-style pours along the
    power nets and a 5x3 via grid in the thermal pad. Both are DRC-clean.
    gen_fab.py builds a 3x2 V-cut panel with 5 mm rails, fiducials and
    tooling holes, plus JLC gerbers, BOM an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
    [drv8874_carrier-B_Cu.gbl, drv8874_carrier-B_Mask.gbs, drv8874_carrier-B_Paste.gbp, drv8874_carrier-B_Silkscreen.gbo, drv8874_carrier-Edge_Cuts.gm1, drv8874_carrier-F_Cu.gtl, drv8874_carrier-F_Mask.gts, drv8874_carrier-F_Paste.gtp]
2026-10-27 DRV8874 carrier: RFQ package for version B
    gen_rfq.py writes fab/b/rfq/: panel and single-board gerbers, a complete
    BOM (manufacturer part numbers, per-board and per-panel quantities, and
    the hand-fitted headers), CPLs in mm from the lower-left corner, and a
    notes file with the board and assembly spec, all also in one zip.
    gen_board.py now appends the master board's generator directory to the
    path, so its gen_fab.py no longer shadows this one.
    [BOM.csv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]
2026-10-27 DRV8874 carrier: JLC upload folder for the 6-up version B panel
    The JLC-format gerbers, BOM and CPL for the panel go into one folder,
    numbered in upload order. JLC rejected a mix of the RFQ BOM (per-board
    designators) and a panel CPL.
    [2_BOM_drv8874_6up.csv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]
2026-10-27 DRV8874 carrier: JLC upload folder for a single version B board
    For quoting single boards against the 6-up panel.
    [2_BOM_drv8874_single.csv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]
2026-10-27 DRV8874 carrier: Basic parts only besides the DRV8874, add C4
    - C1, C2: 10 uF 25 V 0805 (C15850) instead of 50 V 1206 (C13585), much
    cheaper.
    - C5: 22 nF 0402 (C1532, Basic) instead of 0603 (C77571, Extended).
    - R3: 2.4 k (C22940, Basic) instead of 2.49 k. CS reads 1.08 V/A and the
    driver limit is about 3.1 A.
    - C4: second 100 nF on VM, by the VM header pin, as on Pololu's board.
    - A no-tracks rule area keeps signals from under U1 on B.Cu, so the
    thermal pad's bottom pour is unbroken. Version B now gets all 15
    thermal vias.
    - R3's GND pad gets its own via. GND is no longer widened (it is poured).
    Firmware: the driver choice is now a menuconfig choice between this
    carrier (default, 1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
    [2_BOM_drv8874_6up.csv, 2_BOM_drv8874_single.csv, BOM.csv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]
2026-10-27 Add a guided web firmware installer and a CI firmware build
    flasher/ is a local web page, like the WLED and Meshtastic web flashers.
    'python3 flasher/serve.py' serves it on localhost, and it flashes the
    ESP32 over Web Serial using ESP Web Tools (bundled, Apache-2.0). It walks
    through checking the browser, picking the motor-driver variant, preparing
    the controller, installing (erase only on a first install), joining the
    controller's Wi-Fi and the first-run steps.
    build_firmware.py builds all three driver variants (CGW carrier, Pololu
    #4035, Pololu #4036) with ESP-IDF or in Docker. It writes ESP Web Tools
    manifests and flashes the parts at their own offsets, so updates keep
    NVS. Tested with e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
2026-10-27 Master board: silkscreen labels and a larger CGW logo
    gen_silk.py runs after routing and labels the power inputs (12V IN,
    12V IN 2, 18 V max), both fuse options, the E-stop, the TVS choice, the
    buck module and its pins, the I2C and GPIO headers pin by pin, the driver
    sockets (M1-M6 with joint names), the status LEDs and the DB-50.
    It also moves the DevKit's 5V/3V3/GND marks inward, clear of the board
    edge and the pins, adds a USB-end arrow, and puts the CGW logo bottom
    middle at 23 mm (was 14). Copper, mask and drill gerbers are unchanged;
    only F.SilkS differs.
    [scorbot_controller-B_Cu.gbl, scorbot_controller-B_Mask.gbs, scorbot_controller-B_Paste.gbp, scorbot_controller-B_Silkscreen.gbo, scorbot_controller-Edge_Cuts.gm1, scorbot_controller-F_Cu.gtl, scorbot_controller-F_Mask.gts, scorbot_controller-F_Paste.gtp]
2026-10-27 Flasher: package it as a double-click app for Windows, Linux and macOS
    build_app.py wraps serve.py, the page, ESP Web Tools and the firmware into
    one PyInstaller executable. CI builds it on each OS (Linux on Ubuntu
    22.04 for an older glibc) and attaches ScorbotFlasher-windows.exe,
    -linux.tar.gz and -macos.zip to the firmware-latest release, next to the
    firmware zip.
    serve.py now runs packaged:
    - It serves the page from the bundle.
    - It prefers firmware fetched with --download, kept in a per-user cache.
    - If the port is busy it takes the next free one.
    - It keeps the window open on errors.
    Tested: the Linux app runs from an unrelated folder, serves the page and
    the bundled firmware, and ref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
2026-10-27 Flasher: serve it from GitHub Pages instead of a packaged app
    CI now deploys the installer page, ESP Web Tools and the firmware it just
    built to https://columbiagadgetworks.github.io/scorbot/ on every firmware
    or flasher change on main. Nothing to download or install: open it in
    Chrome or Edge and flash over USB.
    This drops the PyInstaller apps (build_app.py and the Windows/Linux/macOS
    jobs). serve.py stays as an optional offline/local server, without the
    packaged-app code. The firmware zip is still attached to the
    firmware-latest release.
2026-11-07 Add a project summary and JLC part-number notes
    SUMMARY.md covers the state of the master board, the DRV8874 carrier, the
    firmware and the web flasher, the repo conventions, and the open items
    for continuing the project. JLCPCB_PART_NUMBERS.md records how the LCSC
    part numbers were found and checked.
2026-11-09 Firmware: filter VM/nFAULT glitches, log faults, show the last restart reason
    E-stop now latches only after motor power has read as missing for 20 ms,
    and a driver fault needs nFAULT low for 5 ms. nFAULT is also ignored for
    the first 10 ms after enabling, while the DRV887x charge pump starts. A
    single noisy reading of the TCA9555 port no longer stops the arm. Real
    E-stops and driver faults still latch within a few tens of milliseconds.
    Every fault and E-stop is logged on the serial console with its cause, VM,
    VM sense and nFAULT state. The Test tab shows why the ESP32 last restarted
    (power-on, brownout, crash, watchdog) and the uptime, so resets show up.
    New host test for the filtering. 66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
    [api.cpp, api.h, config.h, main.cpp, robot.cpp, robot.h, test_core.cpp, web.cpp]
2026-11-10 Firmware: update over WiFi from GitHub, or from an uploaded .bin
    Settings now has a Firmware panel. It shows the installed version, driver
    build and app slot, and can:
    - check the GitHub Pages site for the latest build and install the one for
    this controller's driver type;
    - install a .bin file uploaded from the browser, with no internet needed.
    The motors are switched off during an update. The flash moves to two
    1.9 MB app slots (partitions.csv) with bootloader rollback: a new image is
    kept only after it has run for 20 s. NVS keeps its old offset and size, so
    the one USB install needed to change the layout keeps WiFi and calibration.
    build_firmware.py bakes the build version into the im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
    [partitions.csv]
2026-11-10 Firmware: fix the flickering motor-power reading in the web UI
    The ADS1115s convert one channel every 2 ms. When WiFi (same core, higher
    priority) delayed the I/O task, vTaskDelayUntil ran the late cycles back to
    back and read a conversion before it had finished. The ADC then returned
    the previous channel's result, so a motor current (~0 V) appeared as VM and
    the reading jumped between 12 V and about 0 V. The I/O loop now reads only
    once both ADCs report the conversion done, and restarts it after ~10 ms if
    not. Phase currents had the same channel mix-up; this fixes them too.
    The VM voltage is lightly smoothed (about 30 ms) for display. The 'motor
    power on/off' state the UI shows is now the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
    [hal_esp32.cpp, hal_esp32.h, robot.cpp]
